aT-404/M2RA/RoboticHand-main/STL Files/Assemble.stl

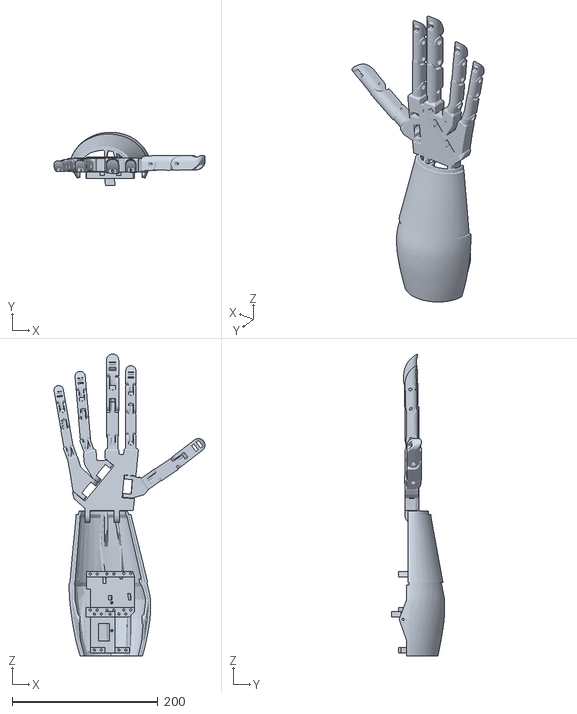
[picture p1: CAD file, 2026-10-23]
RoboticHand-main/STL Files/Assemble.stl
206.9 x 73.3 x 413.9
