aT-404/M2RA/RoboticHand-main/STL Files/1.3mf

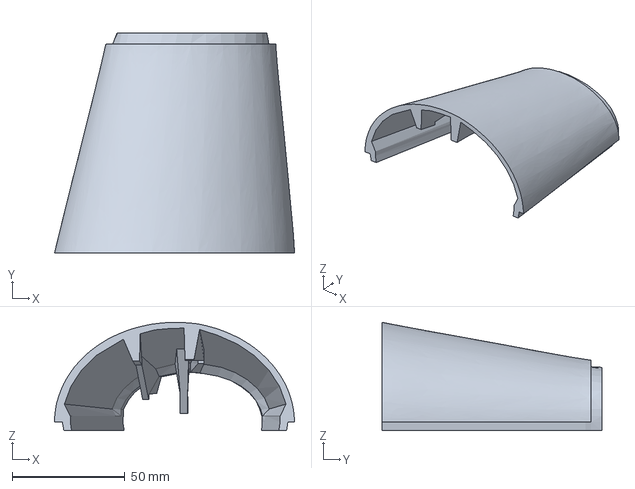
[picture p2: CAD file, 2026-10-31]
RoboticHand-main/STL Files/1.3mf
106.4 x 97.5 x 48.1 mm
