aT-404/M2RA/RoboticHand-main/STL Files/N.STL

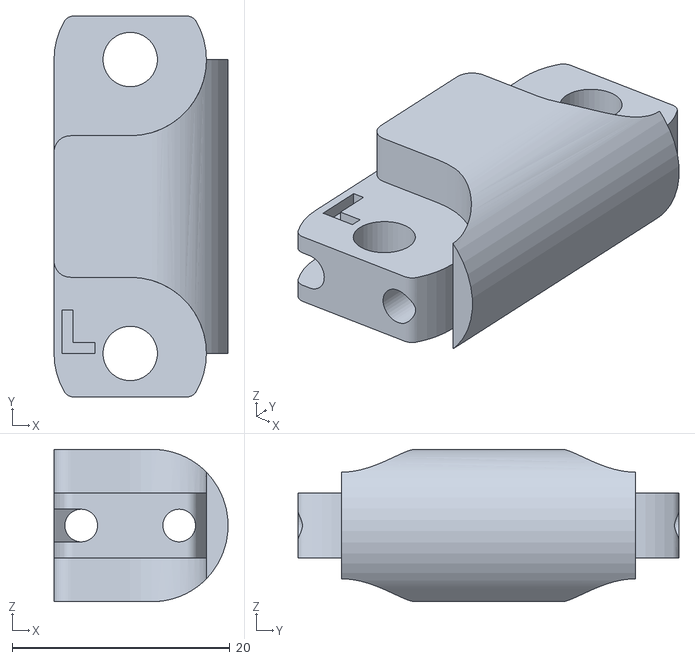
[picture p3: CAD file, 2026-10-23]
RoboticHand-main/STL Files/N.STL
16.0 x 35.0 x 14.0
