aT-404/M2RA/RoboticHand-main/STL Files/E.STL

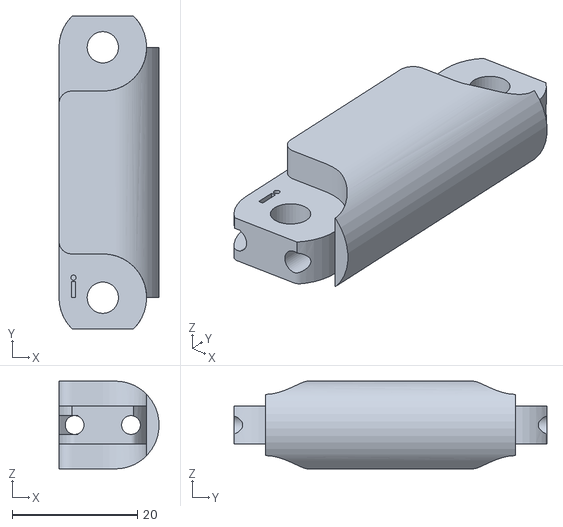
[picture p5: CAD file, 2026-10-23]
RoboticHand-main/STL Files/E.STL
16.0 x 50.0 x 14.0
