aT-404/M2RA/RoboticHand-main/STL Files/5.stl

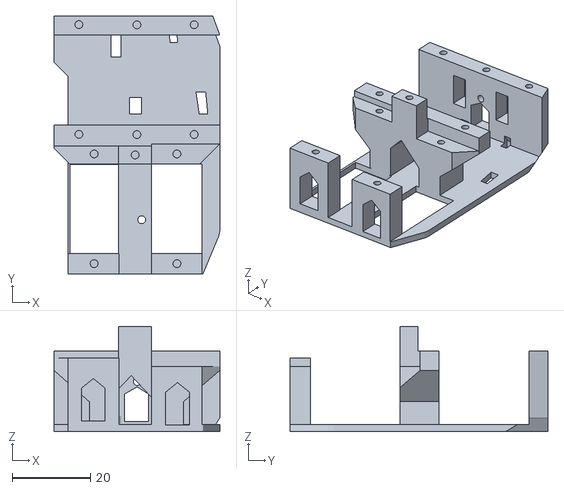
[picture p6: CAD file, 2026-10-23]
RoboticHand-main/STL Files/5.stl
42.3 x 65.8 x 26.8
