aT-404/M2RA/RoboticHand-main/STL Files/A.STL

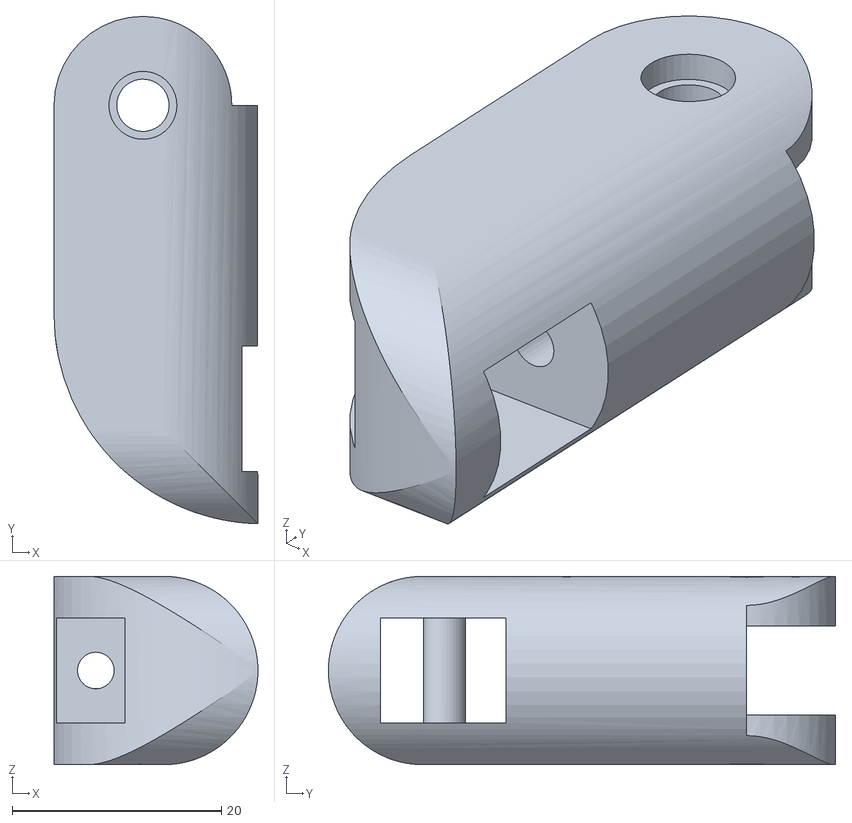
[picture p7: CAD file, 2026-10-23]
RoboticHand-main/STL Files/A.STL
19.5 x 48.5 x 18.0
