aT-404/M2RA/RoboticHand-main/STL Files/M.STL

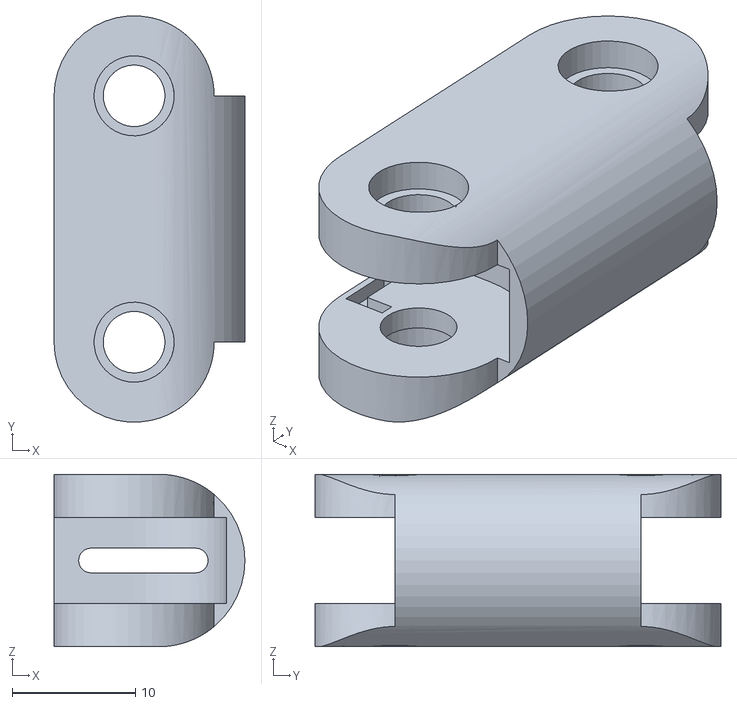
[picture p8: CAD file, 2026-10-23]
RoboticHand-main/STL Files/M.STL
15.5 x 33.0 x 14.0
