aT-404/M2RA/RoboticHand-main/STL Files/2.stl

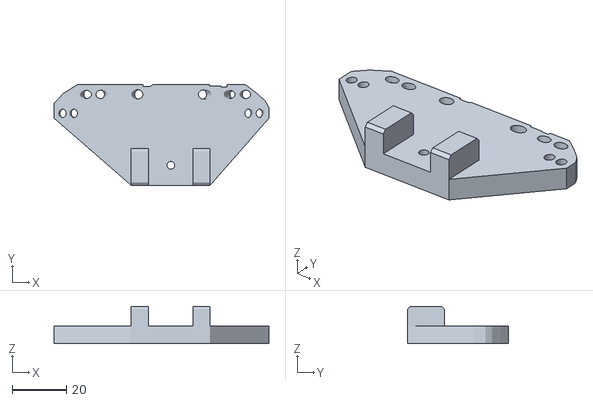
[picture p9: CAD file, 2026-10-23]
RoboticHand-main/STL Files/2.stl
79.3 x 37.1 x 13.8
