aT-404/M2RA/RoboticHand-main/STL Files/P3.stl

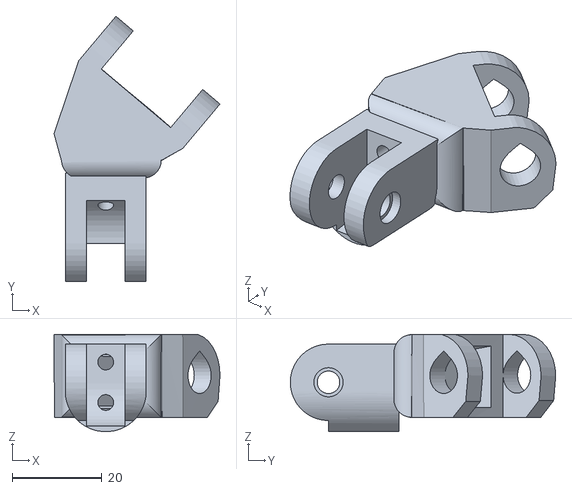
[picture p10: CAD file, 2026-10-23]
RoboticHand-main/STL Files/P3.stl
36.9 x 59.0 x 21.6
