aT-404/M2RA/RoboticHand-main/STL Files/3.stl

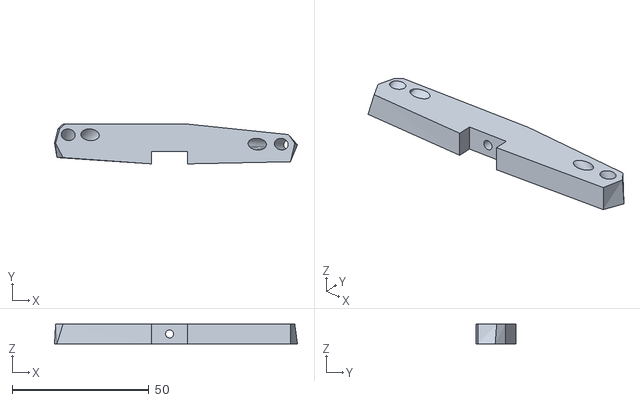
[picture p11: CAD file, 2026-10-23]
RoboticHand-main/STL Files/3.stl
88.7 x 14.5 x 7.17
