aT-404/M2RA/RoboticHand-main/STL Files/C.STL

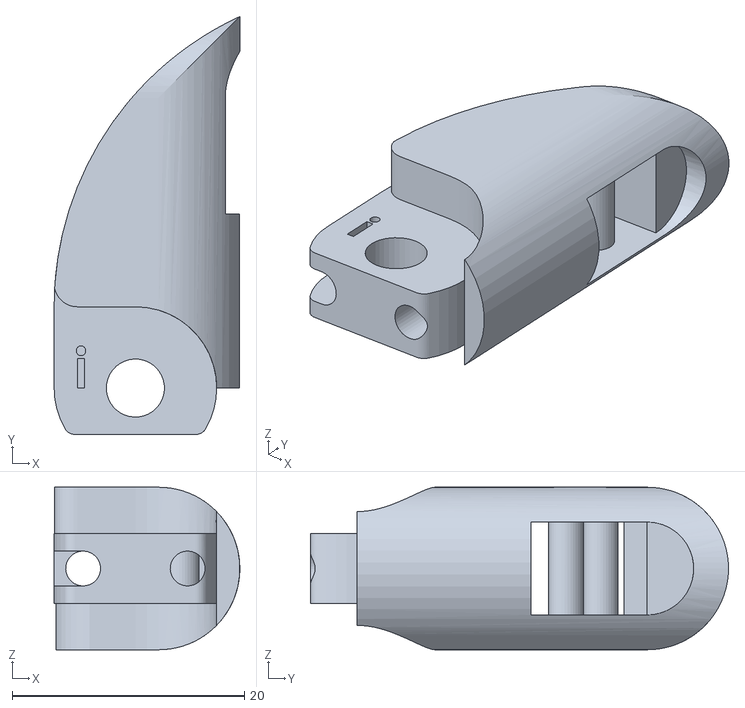
[picture p12: CAD file, 2026-10-23]
RoboticHand-main/STL Files/C.STL
16.0 x 36.0 x 14.0
