aT-404/M2RA/RoboticHand-main/STL Files/K.STL

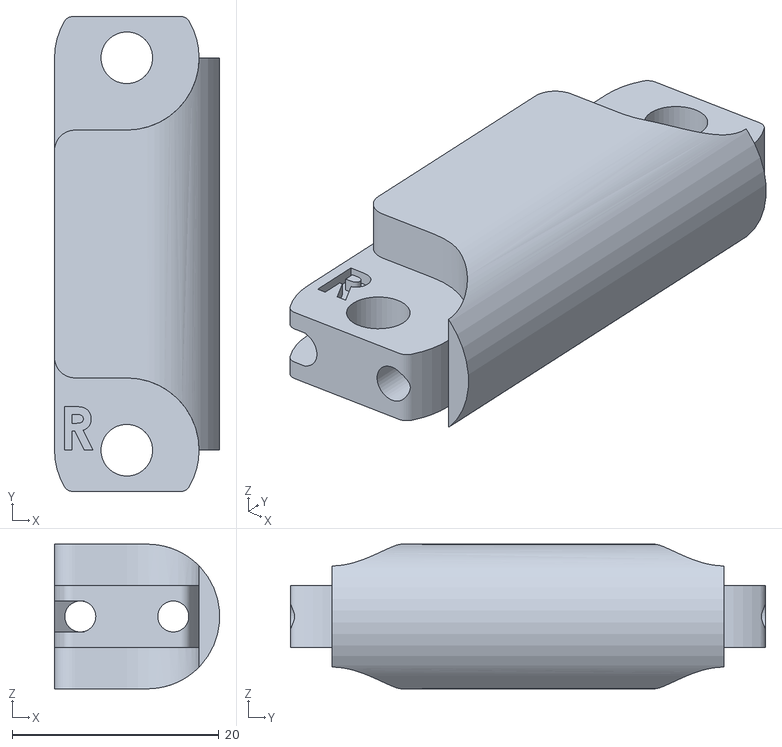
[picture p13: CAD file, 2026-10-23]
RoboticHand-main/STL Files/K.STL
16.0 x 46.0 x 14.0
