aT-404/M2RA/RoboticHand-main/STL Files/G.STL

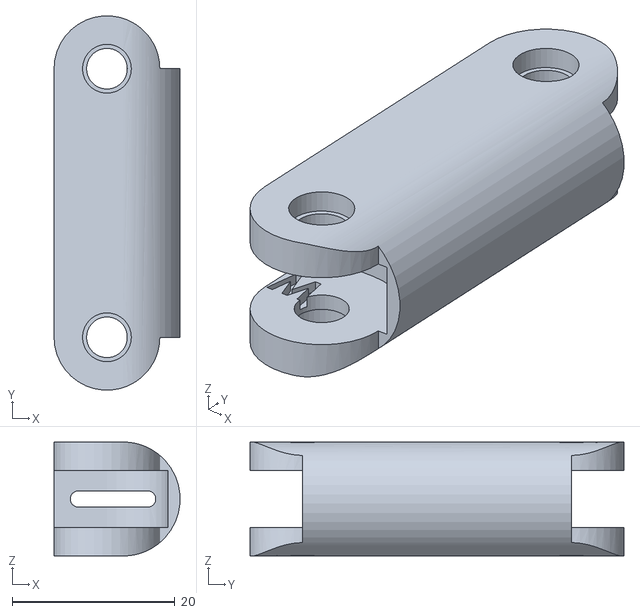
[picture p14: CAD file, 2026-10-23]
RoboticHand-main/STL Files/G.STL
15.5 x 46.0 x 14.0
