aT-404/M2RA/RoboticHand-main/STL Files/6.stl

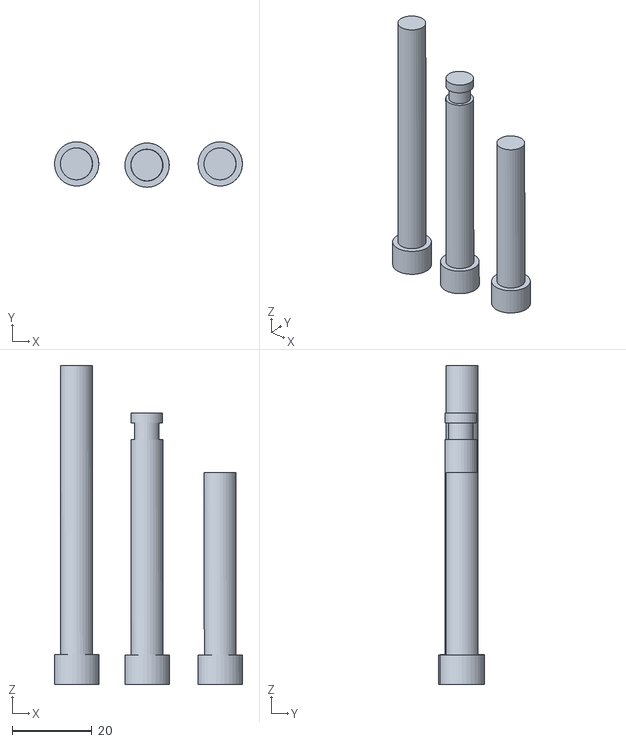
[picture p15: CAD file, 2026-10-23]
RoboticHand-main/STL Files/6.stl
47.1 x 11.4 x 79.9
