aT-404/M2RA/RoboticHand-main/STL Files/J.STL

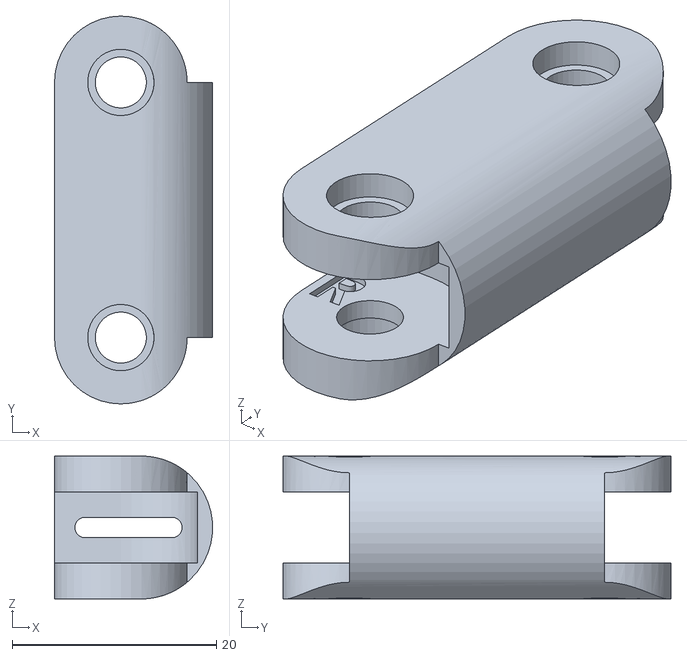
[picture p16: CAD file, 2026-10-23]
RoboticHand-main/STL Files/J.STL
15.5 x 38.0 x 14.0
