aT-404/M2RA/RoboticHand-main/STL Files/4.stl

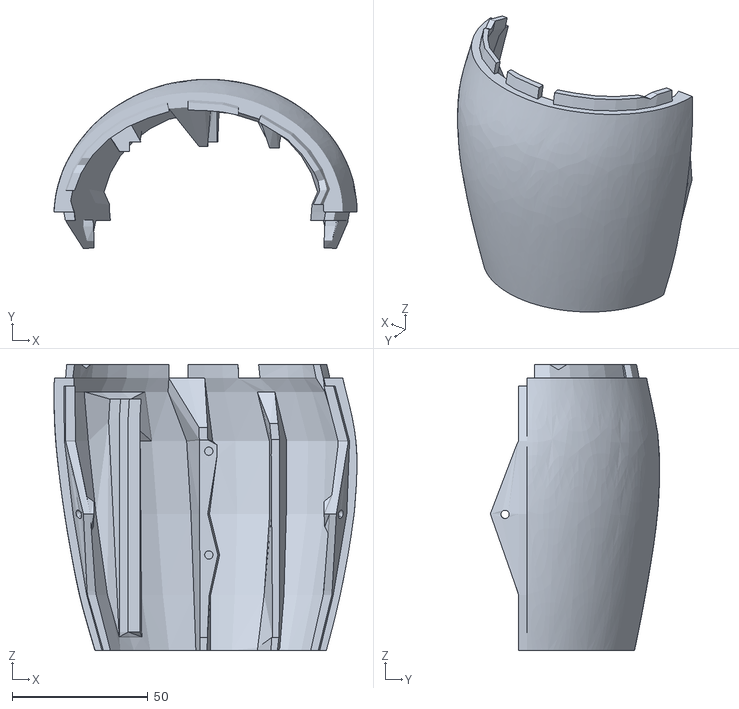
[picture p17: CAD file, 2026-10-23]
RoboticHand-main/STL Files/4.stl
111.8 x 62.5 x 105.6
