aT-404/M2RA/RoboticHand-main/STL Files/F.STL

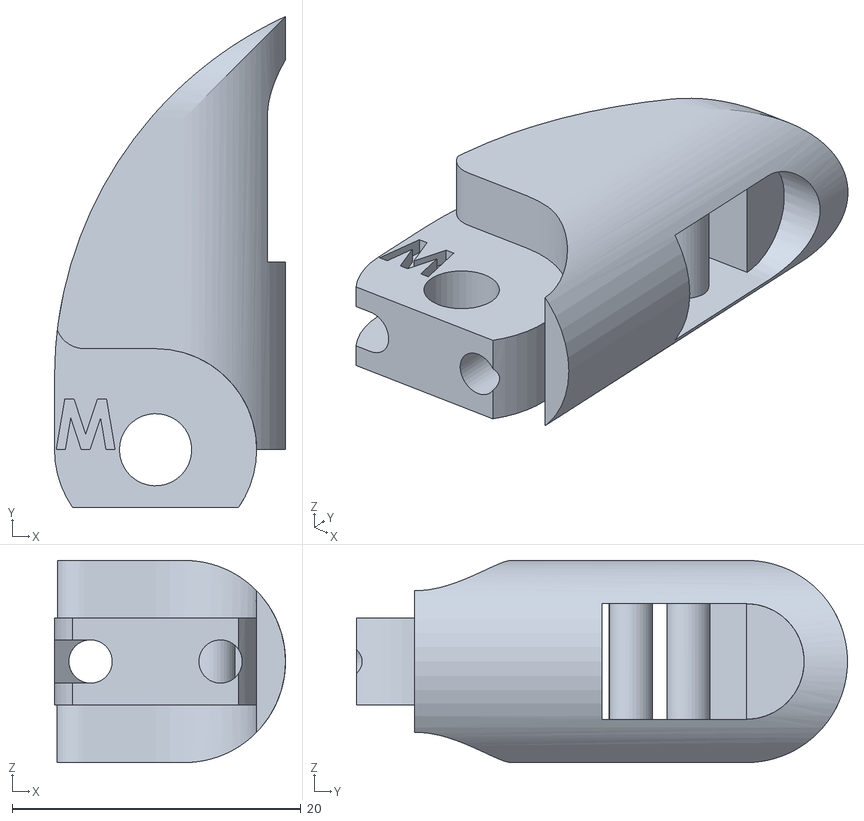
[picture p18: CAD file, 2026-10-23]
RoboticHand-main/STL Files/F.STL
16.0 x 34.0 x 14.0
