aT-404/M2RA/RoboticHand-main/STL Files/H.STL

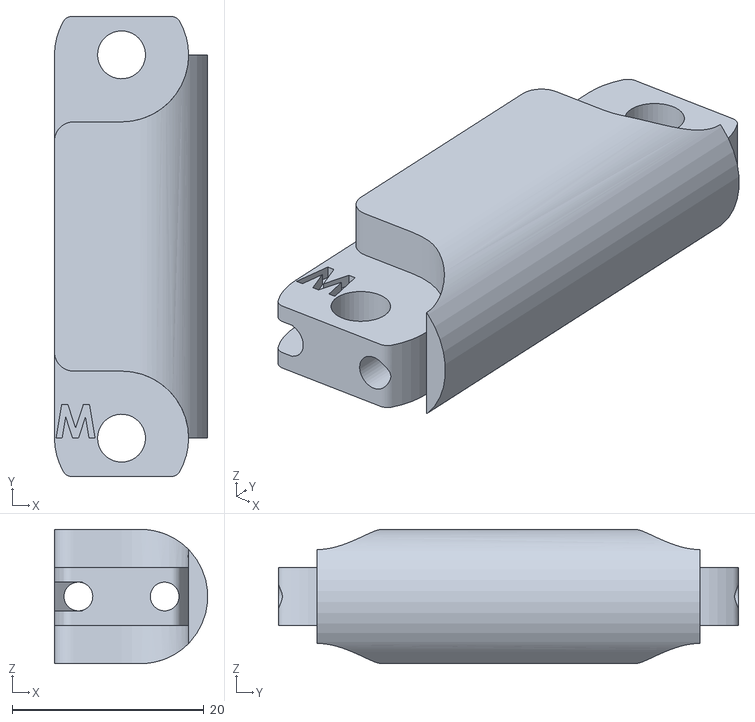
[picture p19: CAD file, 2026-10-23]
RoboticHand-main/STL Files/H.STL
16.0 x 48.0 x 14.0
