aT-404/M2RA/RoboticHand-main/STL Files/P1.stl

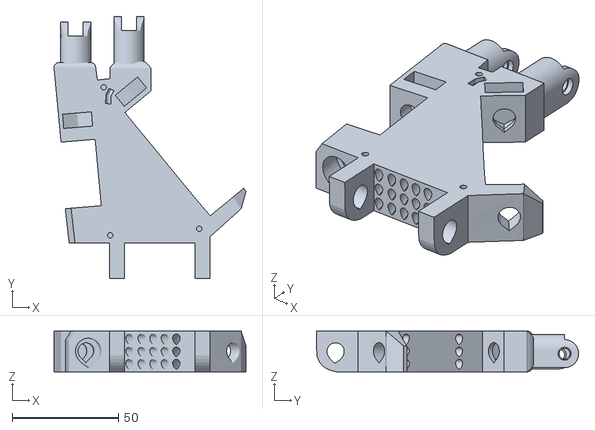
[picture p20: CAD file, 2026-10-23]
RoboticHand-main/STL Files/P1.stl
90.2 x 123.2 x 19.2
