aT-404/M2RA/RoboticHand-main/STL Files/P2.stl

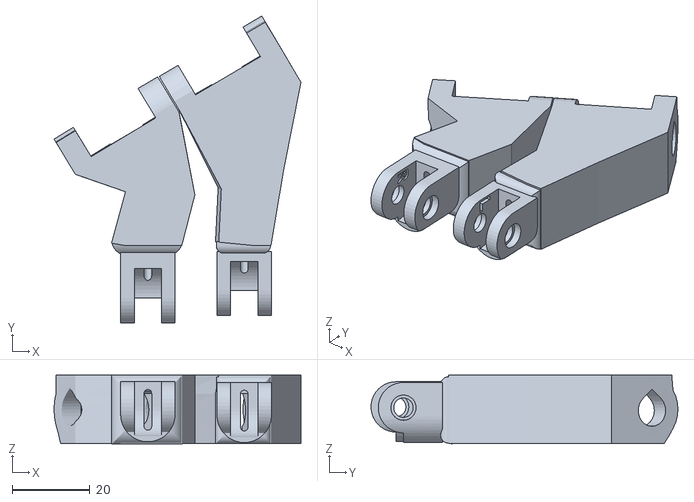
[picture p21: CAD file, 2026-10-23]
RoboticHand-main/STL Files/P2.stl
63.7 x 79.1 x 17.8
