aT-404/M2RA/RoboticHand-main/STL Files/B.STL

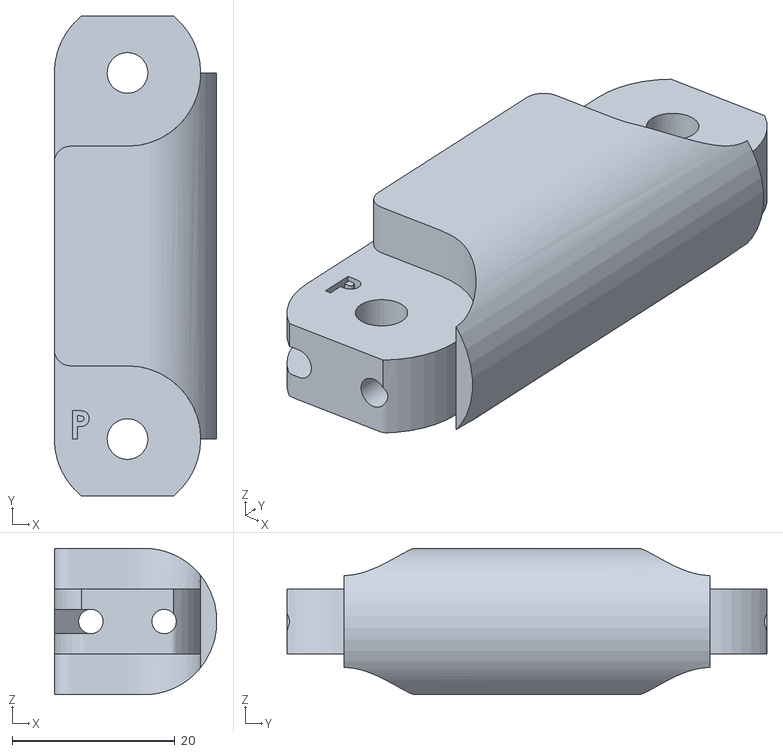
[picture p22: CAD file, 2026-10-23]
RoboticHand-main/STL Files/B.STL
20.0 x 59.0 x 18.0
