aT-404/M2RA/(list of files, cad)

Other CAD files:
RoboticHand-main/STL Files/D.STL
RoboticHand-main/STL Files/I.STL
RoboticHand-main/STL Files/1.stl
