aT-404/M2RA/(commit log)

2026-10-23 feat: complete Phase 1 production release with hardware-free simulator, audit cleanup & comprehensive documentation
    [1.stl, 2.stl, 3.stl, 4.stl, 5.stl, 6.stl, A.STL, Assemble.stl]
2026-10-26 feat: unify bionic hand simulator, slider controls, embedded camera tracking & voice control into single dashboard
2026-10-31 docs: remove audit report and redundant gitignore; update README with project status and EEG modality
    [1.3mf]
